agomezgar/rupertobot/cad/archivosCAD.md

# Archivos en FreeCAD

## Descarga aquí los archivos en FreeCAD
| Imagen | Archivo CAD | Comentario |
|:-:|---|---|
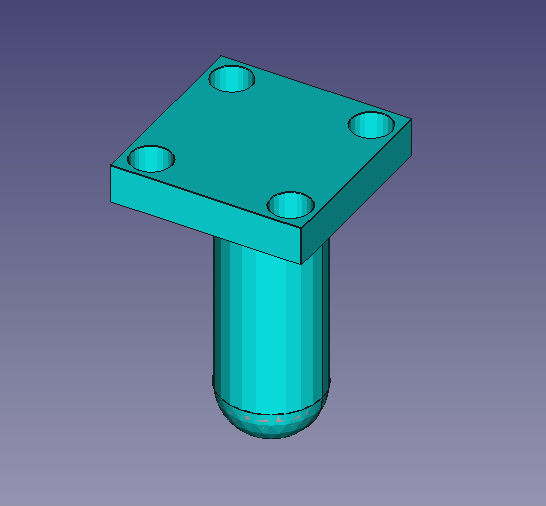
[picture p34: img/3D/ballCaster.png]
Ballcaster
|  | [Ballcaster](../cad/ballcaster.FCStd) | Proporciona un soporte al Rupertobot, intentando reducir el rozamiento con el suelo al mínimo |
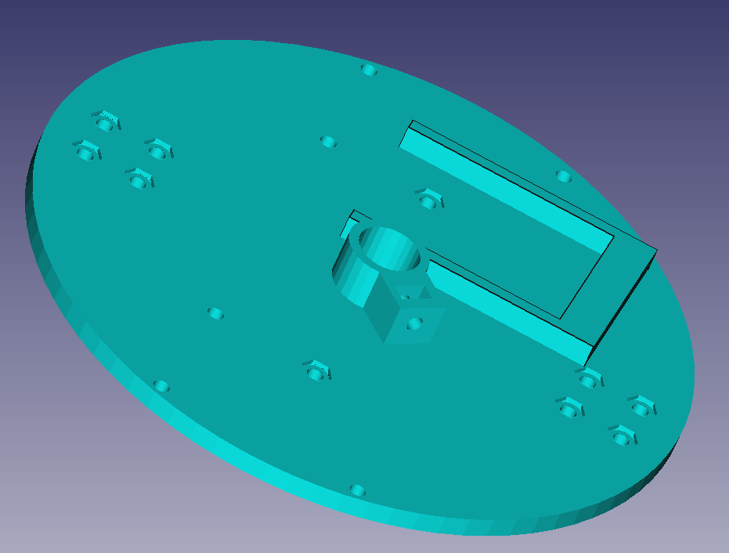
[picture p35: img/3D/plataformaInferior.png]
Plataforma inferior
|  | [Plataforma inferior](../cad/plataformaInferior.FCStd) | Incorpora un sistema de sujeción para bolígrafo o rotulador (experimental, pero la idea es que el Rupertobot acabe dibujando) |
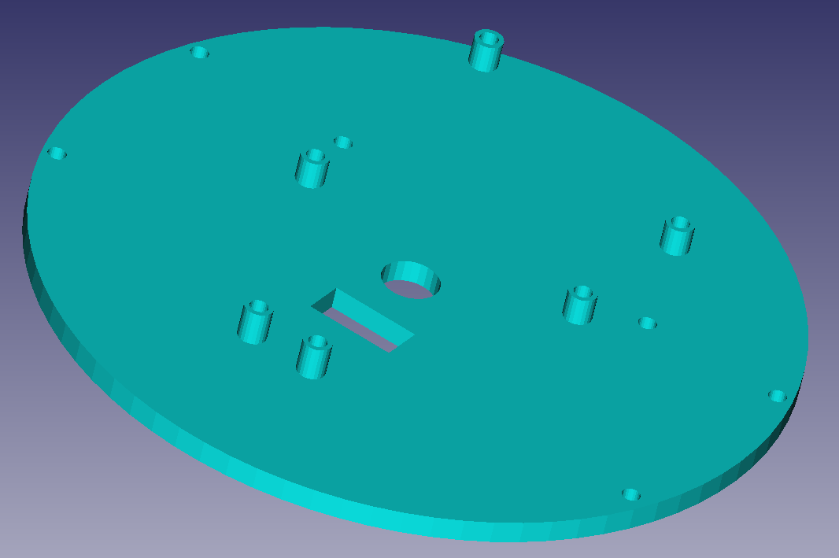
[picture p36: img/3D/plataformaSuperior.png]
Plataforma superior
|  | [Plataforma superior](../cad/plataformaSuperior.FCStd) | Tiene pendiente alguna señal que mejore la orientación a la hora de montarlo sobre la plataforma inferior |
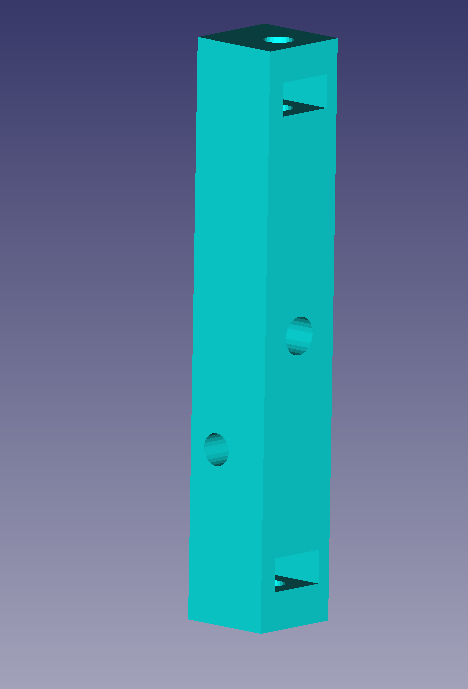
[picture p37: img/3D/columna.png]
Columna
|  | [Columna](../cad/columna.FCStd) | Une las plataformas superior e inferior con un ingenioso (a mí me lo parece) sistema de tornillos y tuercas (Necesitas imprimir seis) |
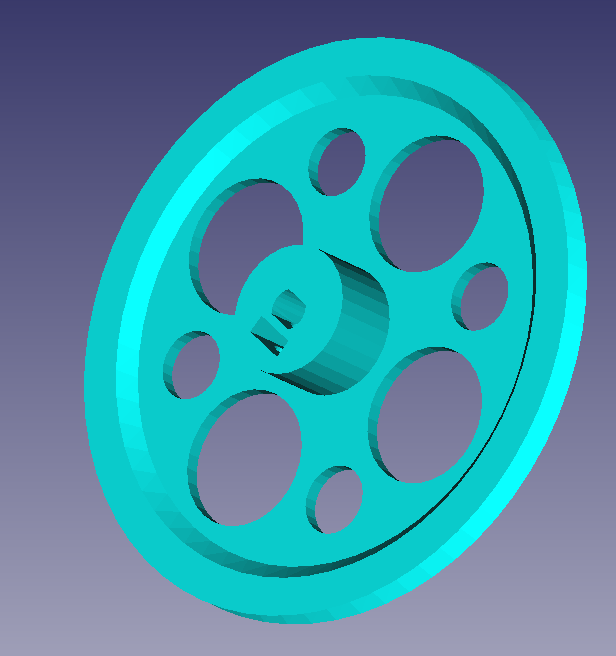
[picture p38: img/3D/ruedaMasaylo.png]
Rueda
|  | [Rueda](../cad/ruedas.FCStd) | La rueda es la del Masaylo (que para eso lo diseñé yo, aunque me ayudaron los compis del Club de Robótica de Granada). En realidad, te sirve cualquier rueda del Escornabot |  
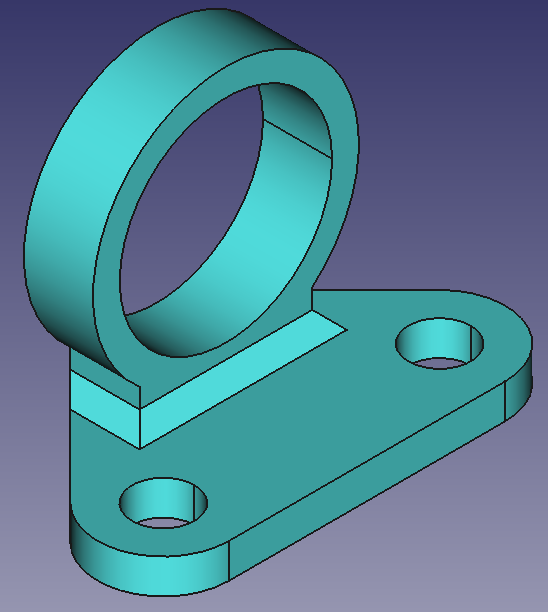
[picture p39: img/3D/soporteZumbador.png]
Soporte del zumbador
|  | Esta pieza, lo confieso, se la he fusilado directamente desde nuestro Masaylo a [Federico Coca](https://github.com/fgcoca). Que la fuerza te acompañe siempre, Fede. |
