agomezgar/rupertobot/STL/archivosSTL.md

# Archivos en STL

## Descarga aquí los archivos en STL
| Imagen | Archivo STL | Comentario |
|:-:|---|---|
| Ballcaster | [Ballcaster](../STL/ballCaster.stl) | Proporciona un soporte al Rupertobot, intentando reducir el rozamiento con el suelo al mínimo (todavía estoy decidiendo si lo reduzco un par de mm para mejorar la tracción, a riesgo de aumentar el cabeceo del robot) |
| Plataforma inferior | [Plataforma inferior](../STL/plataformaInferiorPenholder.stl) | Incorpora un sistema de sujeción para bolígrafo o rotulador |
| Plataforma superior | [Plataforma superior](../STL/plataformaSuperior.stl) | Tiene pendiente alguna señal que mejore la orientación a la hora de montarlo sobre la plataforma inferior |
| Columna | [Columna](../STL/columna.stl) | Une las plataformas superior e inferior con un ingenioso (a mí me lo parece) sistema de tornillos y tuercas (Necesitas imprimir seis) |
| Rueda | [Rueda](../STL/rueda.stl) | La rueda es la del Masaylo (que para eso lo diseñé yo, aunque me ayudaron los compis del Club de Robótica de Granada). En realidad, te sirve cualquier rueda del Escornabot |  
| Soporte de zumbador | [Soporte de zumbador](../STL/soporteZumbador.stl) | Pieza fusilada a [Federico Coca](https://github.com/fgcoca) |
