agomezgar/rupertobot/img/secuenciaPines.odt

MOVIMIENTO HACIA ATRÁS

PASO | MOTOR DERECHO | | | | MOTOR IZQUIERDO
| 2 | 3 | 4 | 5 | 6 | 7 | 8 | 9
1 | 0 | 0 | 0 | 1 | 1 | 0 | 0 | 0
2 | 0 | 0 | 1 | 0 | 0 | 1 | 0 | 0
3 | 0 | 1 | 0 | 0 | 0 | 0 | 1 | 0
4 | 1 | 0 | 0 | 0 | 0 | 0 | 0 | 1
