agomezgar/rupertobot/about.md

# ¿Quién soy? ¡Vaya pregunta!

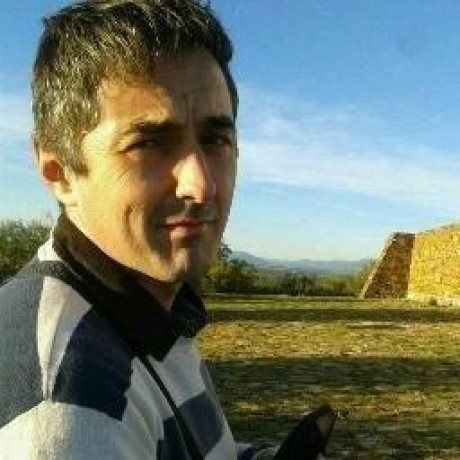
[picture p52: img/perfil.jpg]
Foto de perfil


**Autor**:  Antonio Gómez García

**Bio**: Profe, padre y tecnólogo. Soy penoso en al menos dos de esos perfiles, pero lo intento con toda mi alma todos los días. Soy profe en el [IES Maestro Juan de Ávila](https://maestrojuandeavila.es) de Ciudad Real, como profe de Tecnología, de Robótica y de Ámbito Científico-Tecnológico para los alumnos de Diversificación Curricular. Estos últimos años es lo que más he disfrutado profesionalmente. Como no tengo bastante encima, en la actualidad soy Jefe de Estudios Adjunto, lo que me garantiza un aluvión diario de marrones que voy toreando como mejor puedo, ¡apenas sin llorar!. Soy padre del robot [Masaylo](https://clubroboticagranada.github.io/MASAYLO-CRG), que los amiguetes del [Club de Robótica de Granada](https://clubroboticagranada.github.io/) me ayudaron a digievolucionar hasta su versión 2.0. Soy aficionado a la robótica, la impresión 3D, y el mundo maker en general.

**Presencia en las redes**: Puedes echar un vistazo a mis movidas en mi web del [Aprendiz de Tecnólogo](https://www.aprendizdetecnologo.es); aunque la tengo un poco desactualizada, la estoy recuperando. También actúo bastante en [Twitter](https://twitter.com/antoniotecnocr) (sigo llamando Pryca al Carrefour, me vas a decir a mí que llame a esto X).  

**Publicaciones**  
Aparte de artículos varios en distintos medios (puedes cotejarlos en mi web), soy el orgulloso coautor de dos libros: **Robótica con Arduino** y **Scratch en el cole**, gracias al buen hacer y la disposición de los amigos de <a href="https://serendipiaeditorial.com" target="new">Serendipia Editorial</a>

  | | | 
| :-----------: | :----------: |
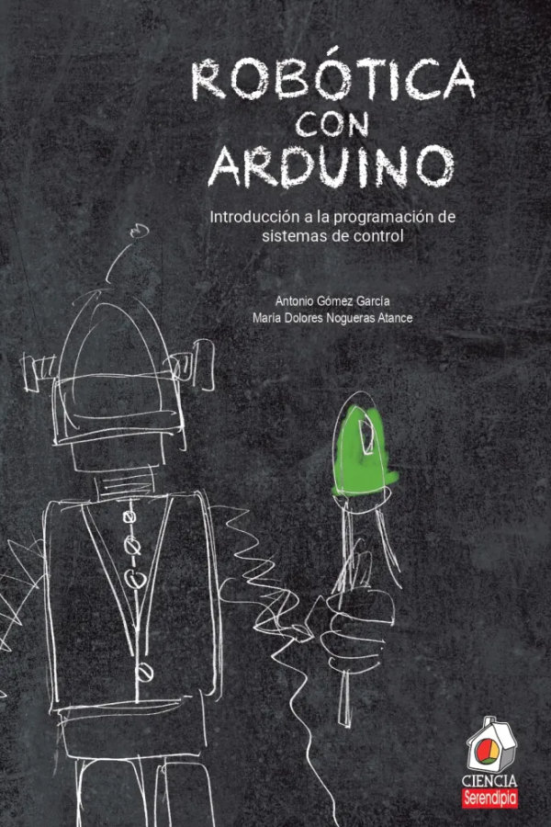
[picture p53: img/roboticaconArduino.jpg]
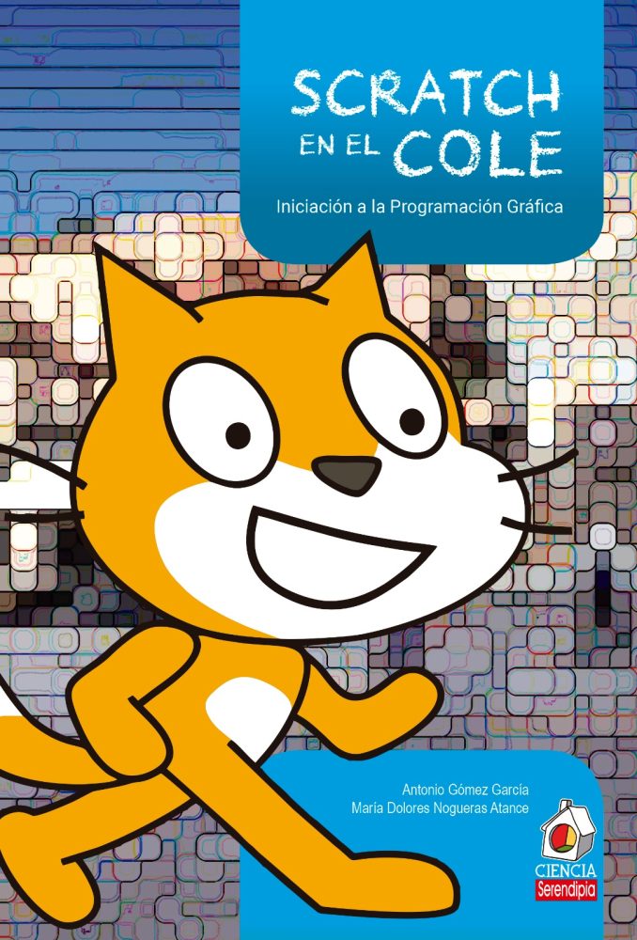
[picture p54: img/scratchenelCole.jpg]
|   | |

**Motivaciones**

Tengo hambre de SABER, porque quiero ENTENDER. Nadie dijo que tengas que hacerme caso. Yo no lo haría.
