agomezgar/rupertobot/archivos/cad.md

# FreeCAD

Aquí tienes los archivos de RupertoBot en FreeCAD

* [Instalación en Windows](windows.md).
* [Instalación en MacOS](macos.md).
* [Instalación en Linux](linux.md).
