agomezgar/rupertobot/archivos/circuito.pdf

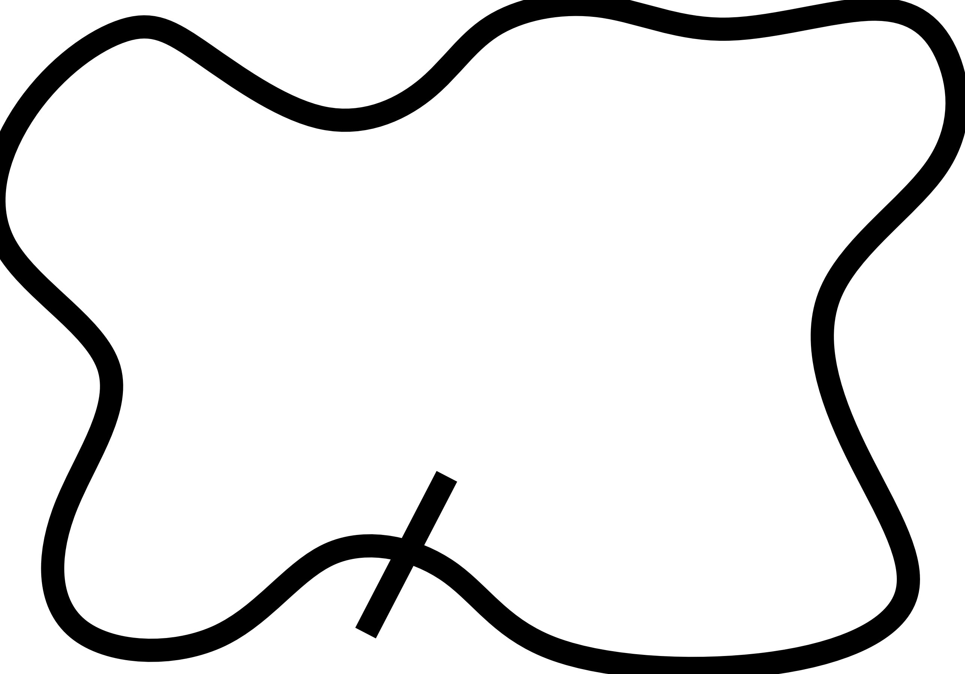
[picture p61: figure]
