agomezgar/rupertobot/img/3D/soporteSensores.png

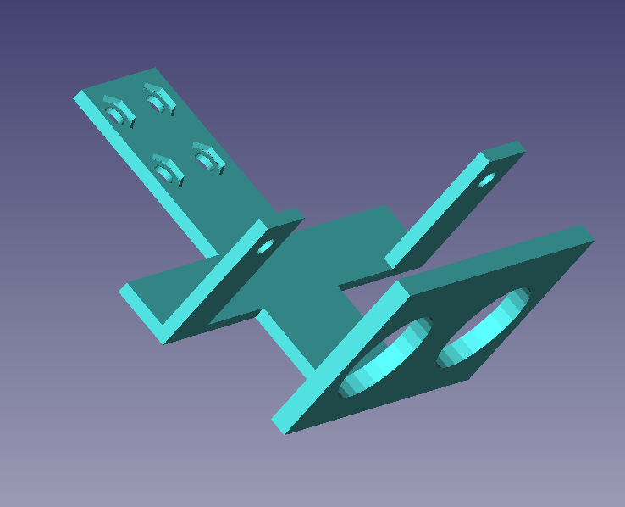
img/3D/soporteSensores.png
