agomezgar/rupertobot/img/3D/soporteSensoresCuernos.png

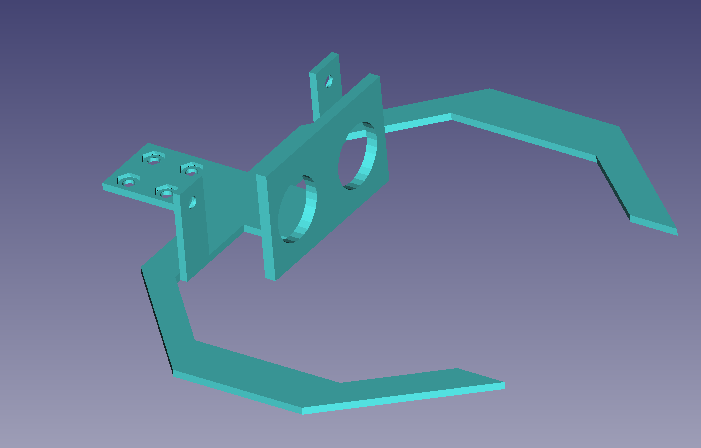
img/3D/soporteSensoresCuernos.png
