agomezgar/rupertobot/img/arduinoIDEInstalarLibreria.png

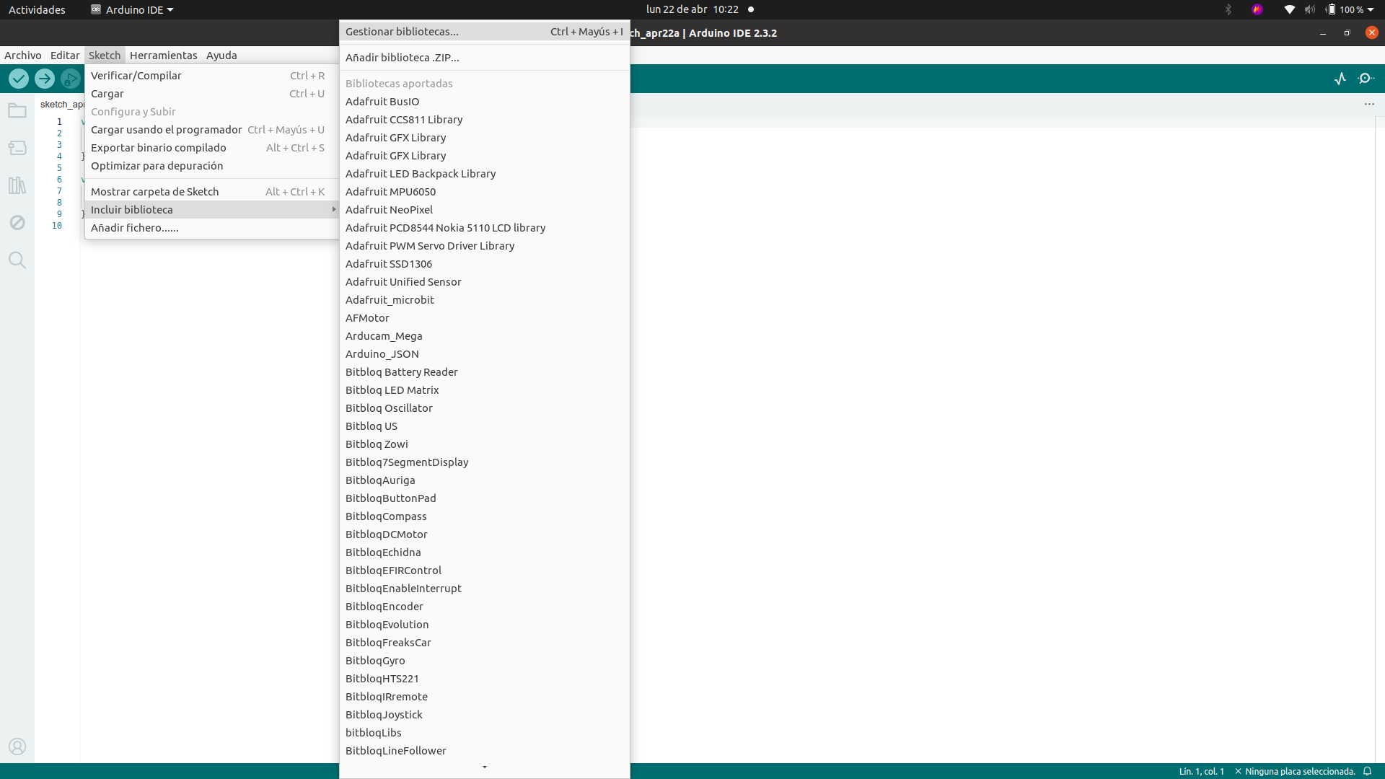
img/arduinoIDEInstalarLibreria.png
