agomezgar/rupertobot/img/arduinoIDEInstalarRupertobot.png

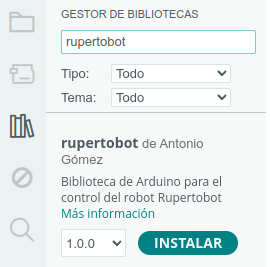
img/arduinoIDEInstalarRupertobot.png
