agomezgar/rupertobot/img/esquemaBase.jpg

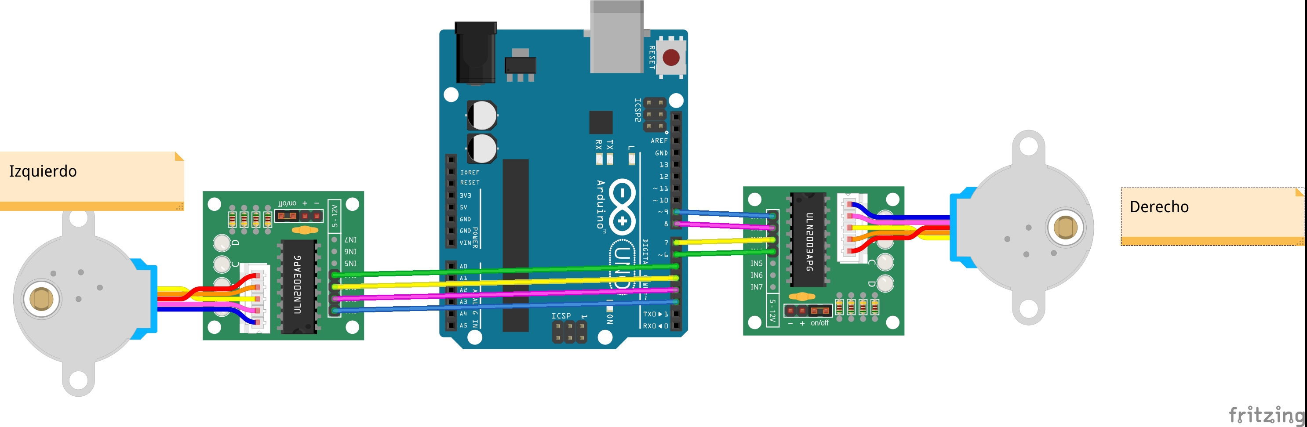
img/esquemaBase.jpg
