agomezgar/rupertobot/img/fotoStepper_files/240x168.png

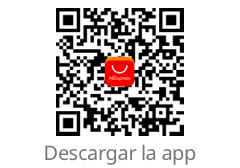
img/fotoStepper_files/240x168.png
