agomezgar/rupertobot/img/fotoStepper_files/Motor-paso-a-paso-de-5V-28BYJ-48-ULN2003-m-dulo-de-prue_003.webp

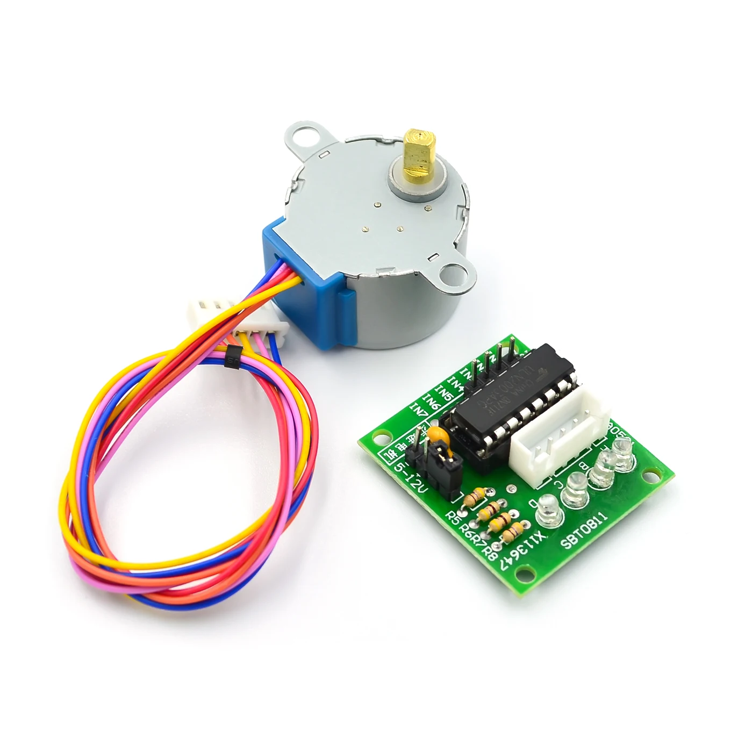
img/fotoStepper_files/Motor-paso-a-paso-de-5V-28BYJ-48-ULN2003-m-dulo-de-prue_003.webp
