agomezgar/rupertobot/img/laberintoBasico.png

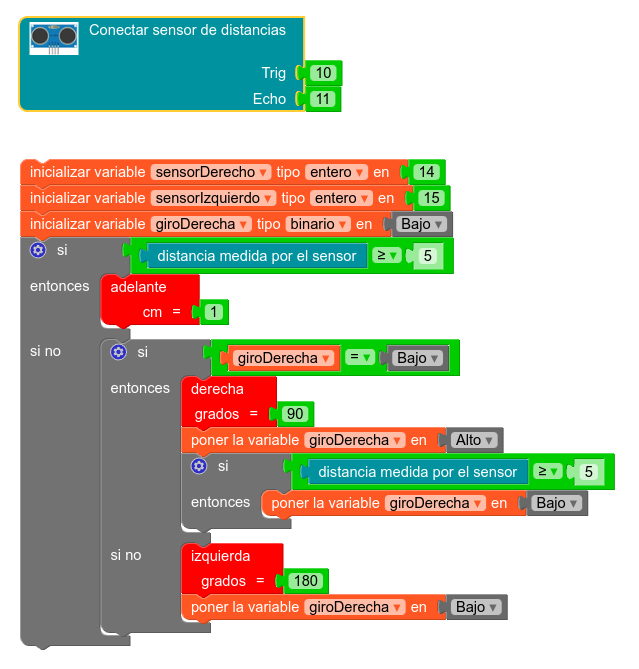
img/laberintoBasico.png
