agomezgar/rupertobot/img/montaColumnas1.png

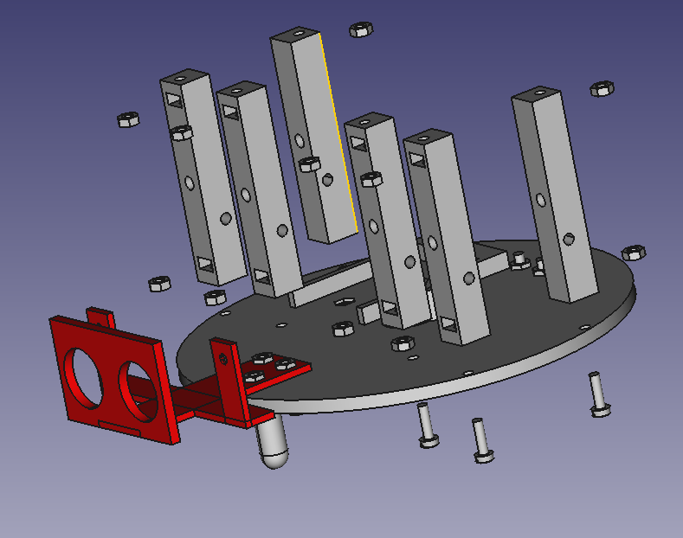
img/montaColumnas1.png
