agomezgar/rupertobot/img/rupertoJedi.png

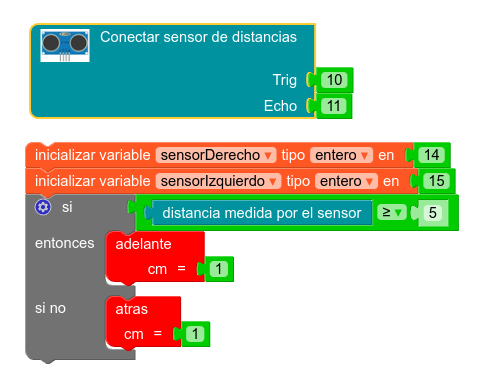
img/rupertoJedi.png
