agomezgar/rupertobot/img/sigueLineasBasico.png

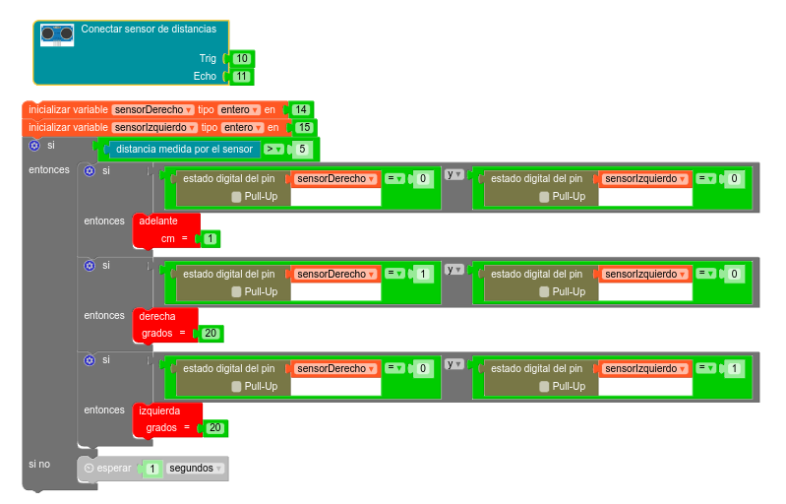
img/sigueLineasBasico.png
