agomezgar/rupertobot/img/stepperDerecho.jpg

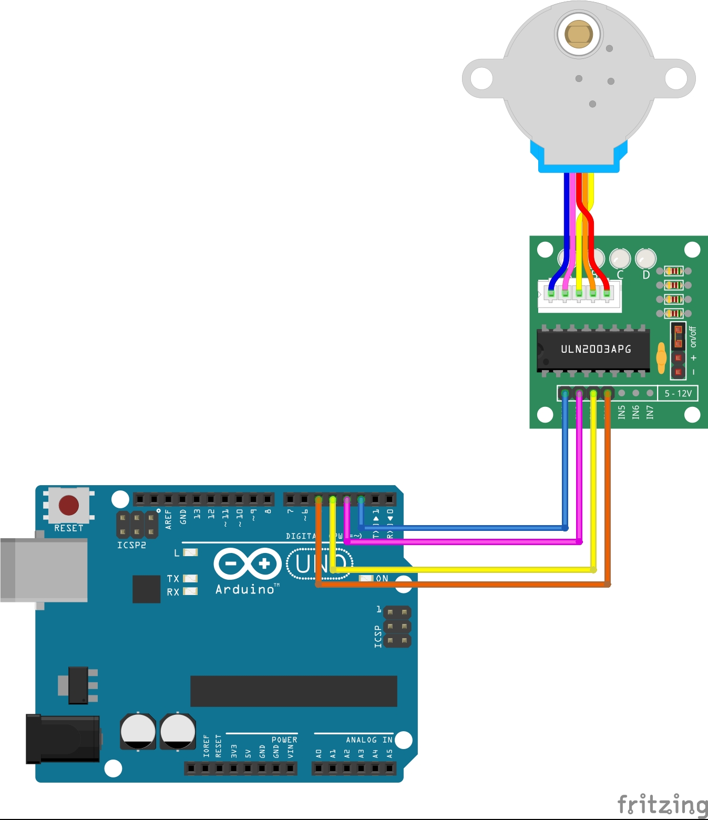
img/stepperDerecho.jpg
