agomezgar/rupertobot/img/stepperDerecho.png

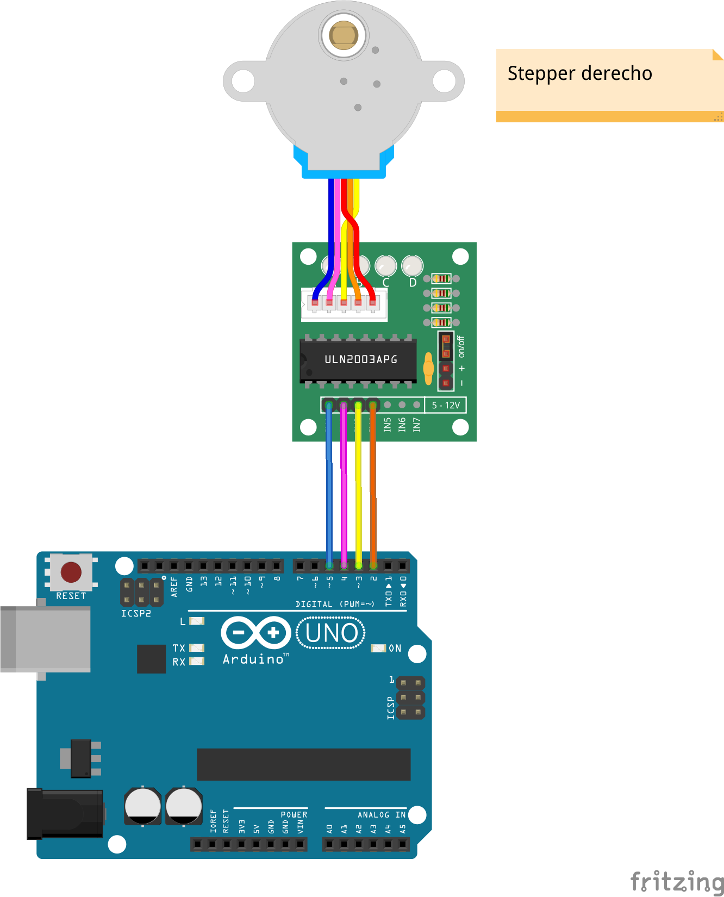
img/stepperDerecho.png
