agomezgar/rupertobot/STL/plataformaInferiorPenholder.stl

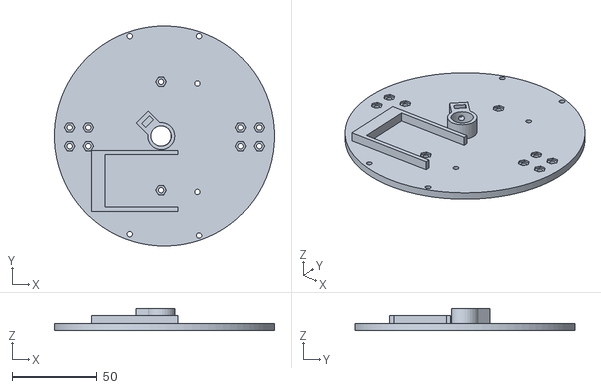
[picture p75: CAD file, 2023-12-23]
STL/plataformaInferiorPenholder.stl
130.0 x 130.0 x 13.0
