agomezgar/rupertobot/cad/plataformaInferior.FCStd

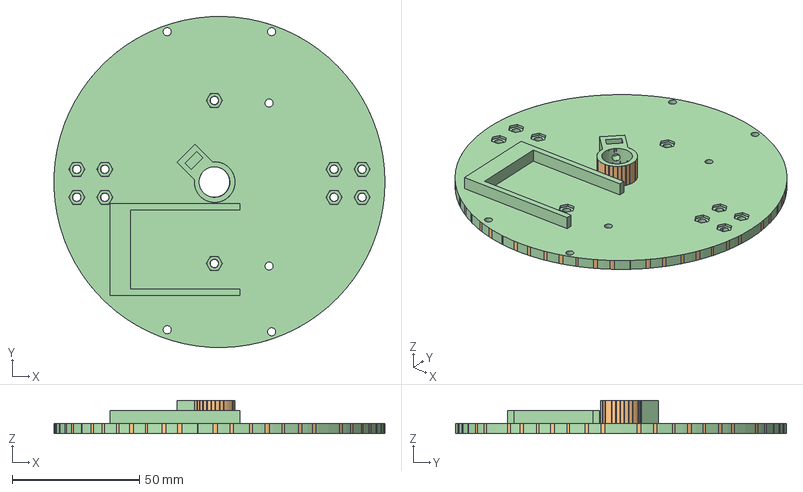
[picture p76: CAD file, 2023-12-23]
cad/plataformaInferior.FCStd
130.0 x 130.0 x 13.0 mm
plataformaInferior
plataformaInferior (Solid)
plataformaInferior (Solid) (Meshed)
