agomezgar/rupertobot/cad/soporteSensoresCuernos.FCStd

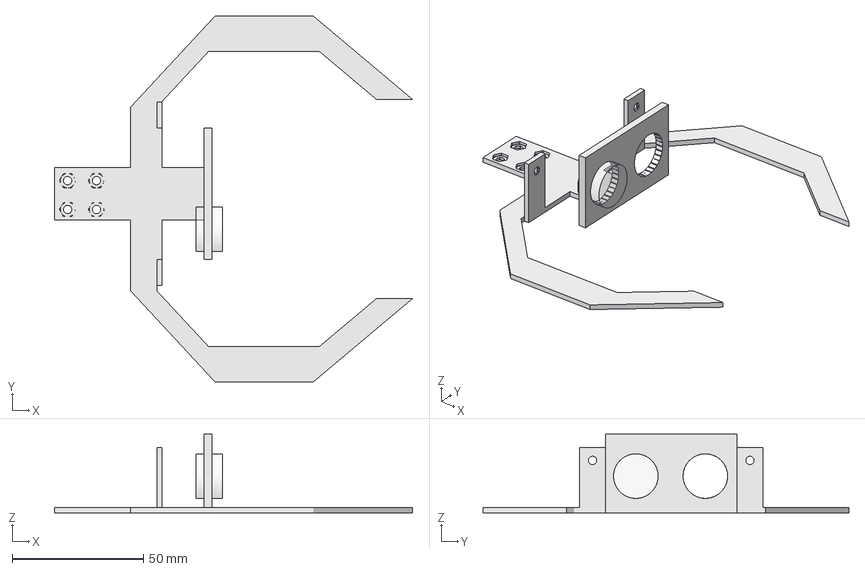
[picture p77: CAD file, 2024-05-05]
cad/soporteSensoresCuernos.FCStd
136.5 x 139.5 x 30.0 mm
Cilindro087
Fusion049 (Meshed)
