agomezgar/rupertobot/STL/ballCasterCorto.stl

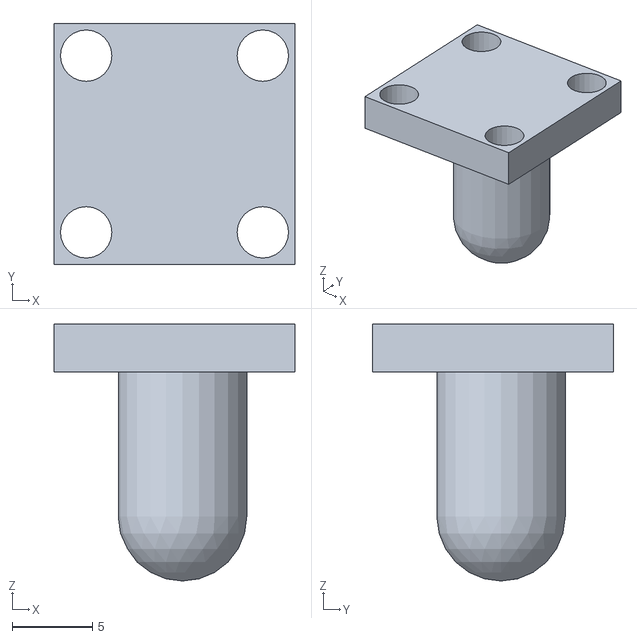
[picture p78: CAD file, 2023-12-23]
STL/ballCasterCorto.stl
15.0 x 15.0 x 16.0
