agomezgar/rupertobot/cad/soporteSensores.FCStd

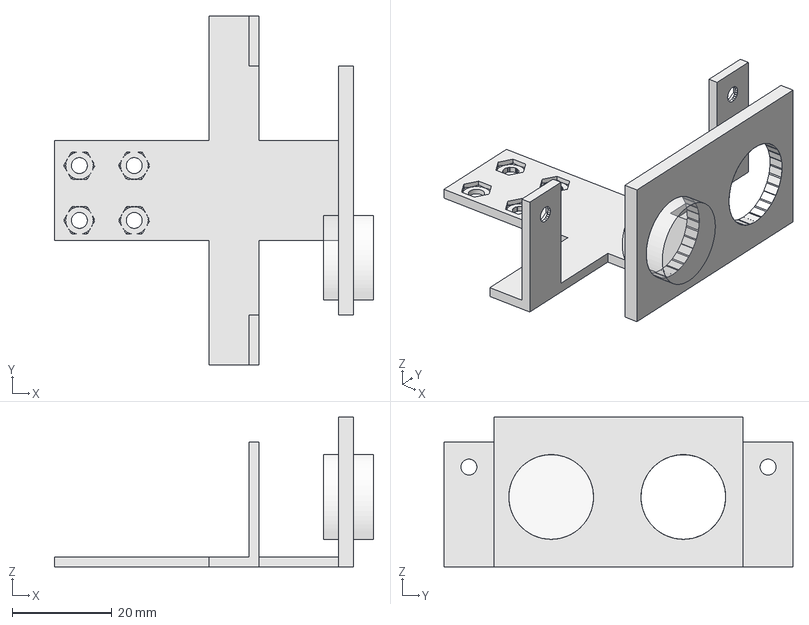
[picture p79: CAD file, 2024-02-04]
cad/soporteSensores.FCStd
64.0 x 70.0 x 30.0 mm
Cilindro087
soporteSensores
soporteSensores (Meshed)
