agomezgar/rupertobot/STL/ballCasterB.stl

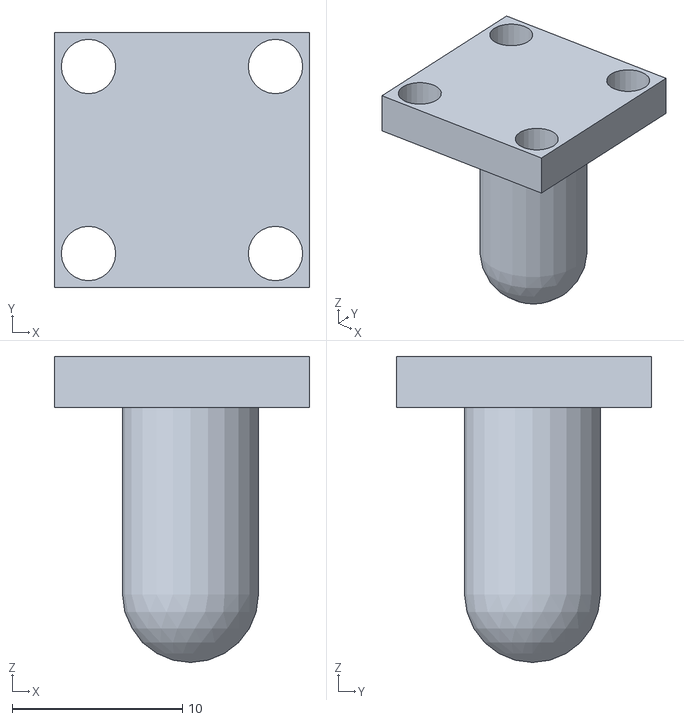
[picture p80: CAD file, 2023-12-23]
STL/ballCasterB.stl
15.0 x 15.0 x 18.0
