agomezgar/rupertobot/cad/soporteZumbador.FCStd

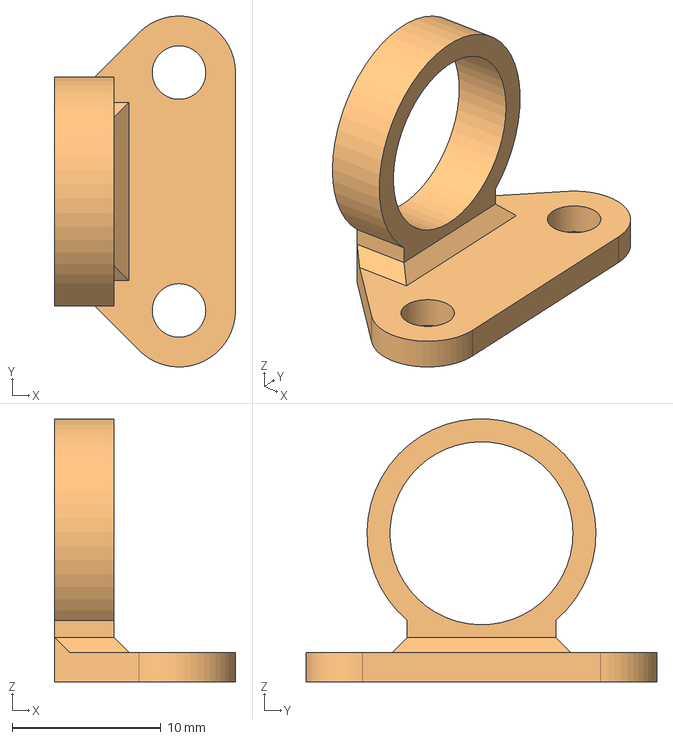
[picture p81: CAD file, 2024-02-04]
cad/soporteZumbador.FCStd
12.2 x 23.6 x 17.7 mm
soporte-zumbador-src (Solid)
