agomezgar/rupertobot/cad/ANIMAMOTORES.FCStd

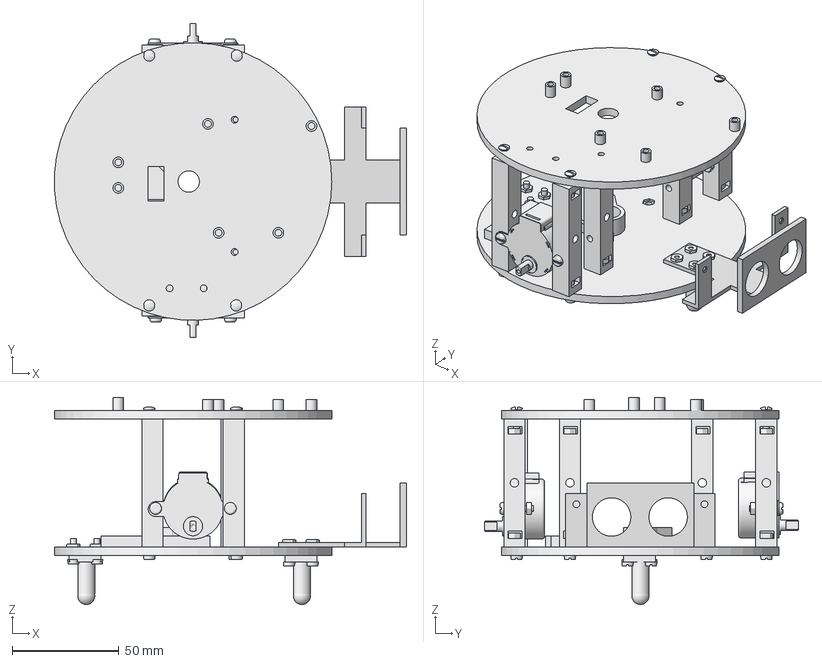
[picture p82: CAD file, 2023-12-31]
cad/ANIMAMOTORES.FCStd
164.9 x 147.0 x 97.0 mm
ballCSensor
plataformaInferior (Solid)
tuercasBallCSensor
tuercasBallCLibre
ballCLibre
soporteSensores (Solid)
tornillosBallClibre
tornillosBallCSensor
M3x14-Tornillo
columnas
tornillosAbajo
tuercasDelante
tuercasAtras
tornillosDerecha
tuercasDerecha
tornillosIzquierda
tuercasIzquierda
plataformaSuperior (Solid)
tornillosSuperiorIzquierda
tornillosSuperiorDerecha
28BYJ-48_v007
28BYJ-48_v6
