agomezgar/rupertobot/STL/ballCasterA (Meshed).stl

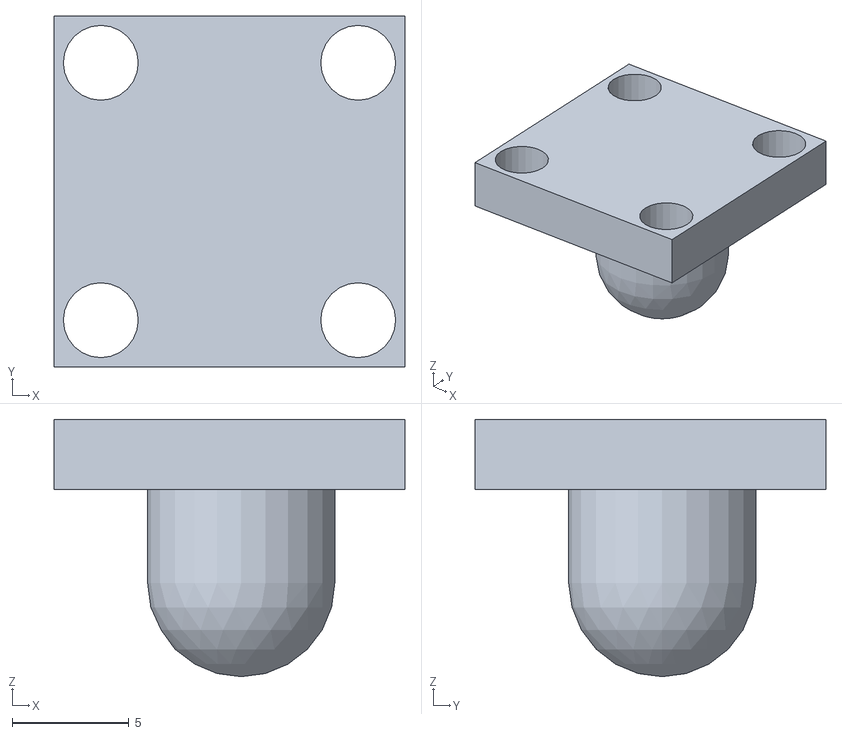
[picture p83: CAD file, 2023-12-23]
STL/ballCasterA (Meshed).stl
15.0 x 15.0 x 11.0
