agomezgar/rupertobot/cad/plataformaSuperior.FCStd

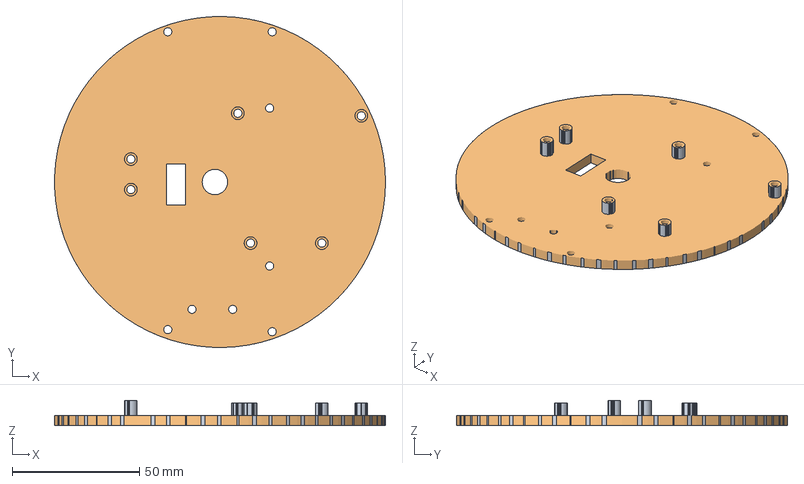
[picture p84: CAD file, 2023-12-31]
cad/plataformaSuperior.FCStd
130.0 x 130.0 x 10.0 mm
plataformaSuperior
plataformaSuperior (Meshed)
