agomezgar/rupertobot/STL/rueda.stl

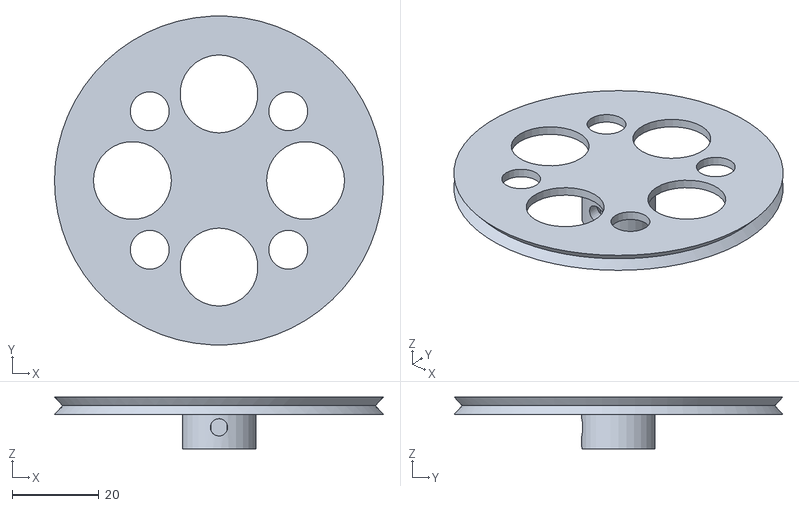
[picture p85: CAD file, 2023-12-23]
STL/rueda.stl
76.0 x 75.9 x 12.0
