agomezgar/rupertobot/cad/ANIMACOLUMNAS.FCStd

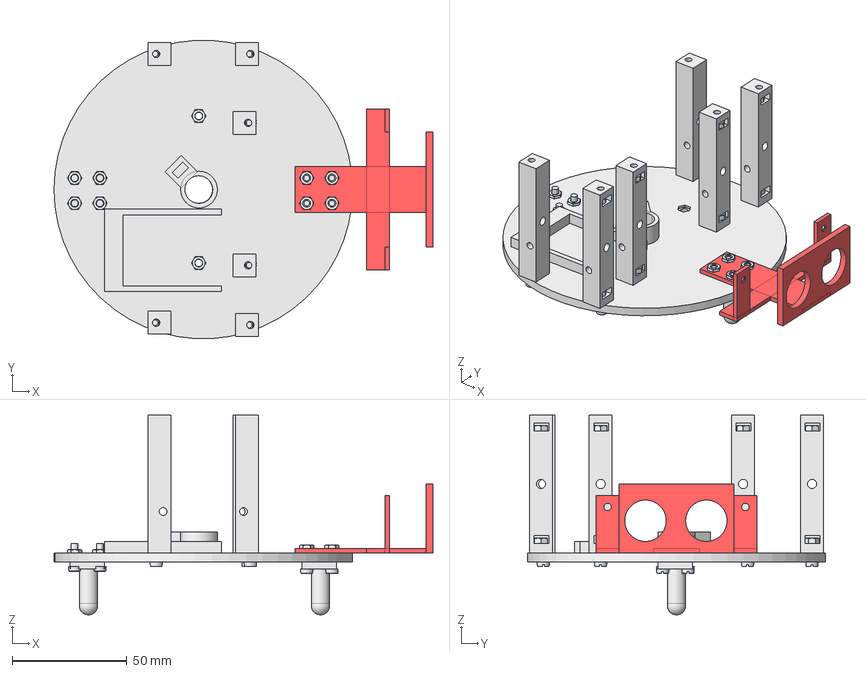
[picture p86: CAD file, 2023-12-31]
cad/ANIMACOLUMNAS.FCStd
165.0 x 129.8 x 87.0 mm
ballCSensor
plataformaInferior (Solid)
tuercasBallCSensor
tuercasBallCLibre
ballCLibre
soporteSensores (Solid)
tornillosBallClibre
tornillosBallCSensor
columnas
tornillosAbajo
tuercasDelante
tuercasAtras
