agomezgar/rupertobot/cad/ANIMABALLCASTER.FCStd

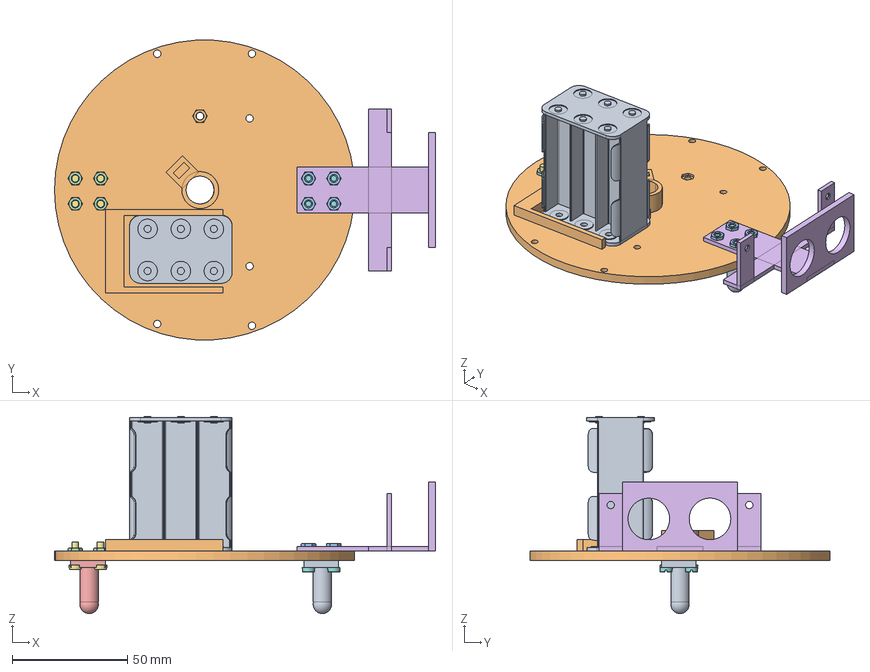
[picture p87: CAD file, 2023-12-31]
cad/ANIMABALLCASTER.FCStd
165.0 x 129.8 x 85.4 mm
ballCSensor
plataformaInferior (Solid)
tuercasBallCSensor
tuercasBallCLibre
ballCLibre
soporteSensores (Solid)
tornillosBallClibre
tornillosBallCSensor
6 x AAA Holder
