agomezgar/rupertobot/cad/columna.FCStd

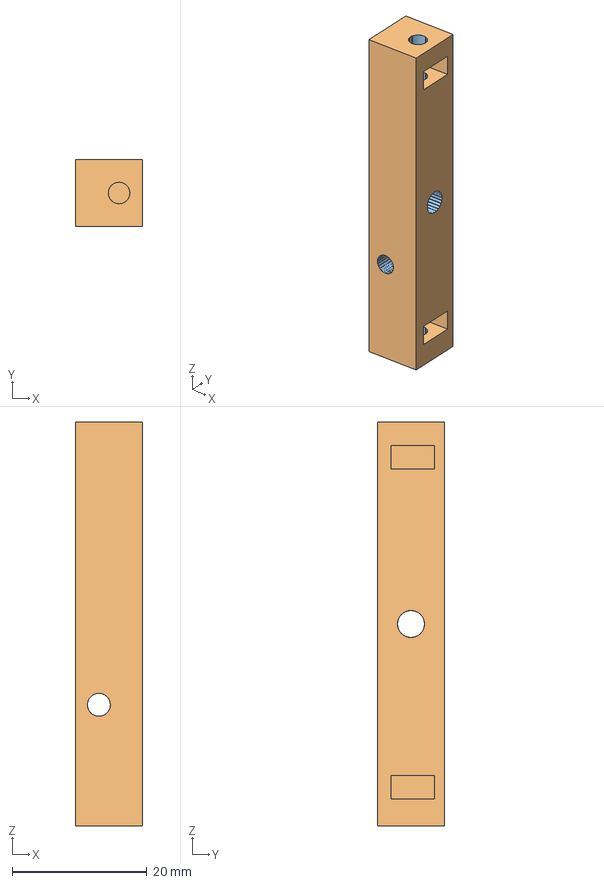
[picture p88: CAD file, 2023-12-23]
cad/columna.FCStd
10.0 x 10.0 x 60.0 mm
columna
columna (Solid)
columna (Meshed)
