agomezgar/rupertobot/cad/ballcaster.FCStd

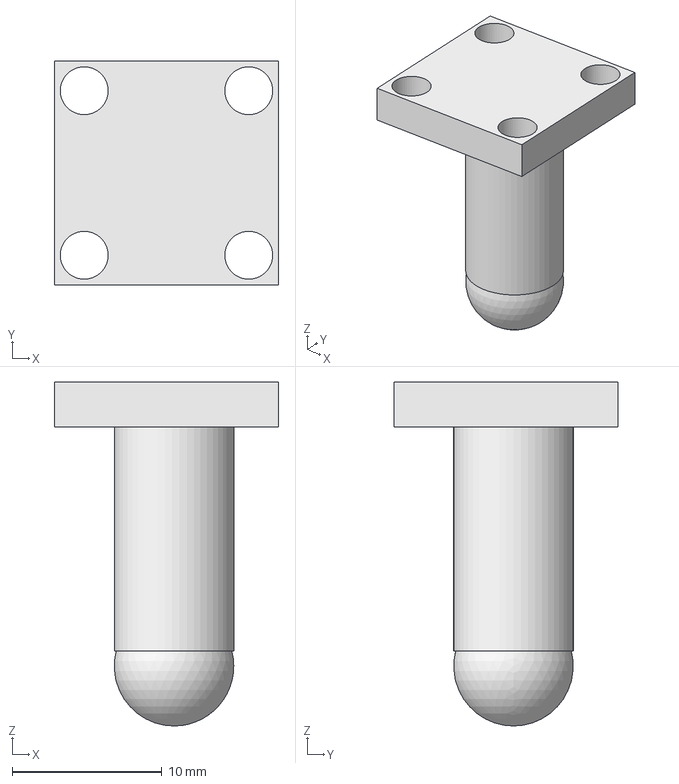
[picture p89: CAD file, 2023-12-23]
cad/ballcaster.FCStd
15.0 x 15.0 x 23.0 mm
