agomezgar/rupertobot/(list of files, cad)

Other CAD files:
cad/ruedas.FCStd
STL/ballCaster.stl
STL/columna.stl
STL/plataformaSuperior.stl
STL/soporteSensores.stl
STL/soporteSensoresCuernos.stl
STL/soporteZumbador.stl
