agomezgar/rupertobot/(list of files, drawings)

Other design files:
circuitos/alimentacionArduino.fzz
circuitos/alimentacionDrivers2.fzz
circuitos/alimentacionDrivers.fzz
circuitos/conexionUS.fzz
circuitos/sensoresIR.fzz
circuitos/stepperDerecho.fzz
circuitos/steppers.fzz
circuitos/zumbador.fzz
img/esquemas/esquemaBase.fzz
