agomezgar/rupertobot/(commit log)

2023-12-23 Prueba de subida
    [ballCaster.stl, ballCasterA (Meshed).stl, ballCasterB.stl, ballCasterCorto.stl, ballcaster.FCStd, columna.FCStd, columna.stl, esquemaBase.fzz]
2023-12-23 Cambio de tema
2023-12-31 Primeras animaciones
    [ANIMABALLCASTER.FCStd, animaciones.FCStd, plataformaSuperior.FCStd, plataformaSuperior.stl, soporte-zumbador-src(1).FCStd]
2023-12-31 Hi once more
    [ballCaster.stl, ballCasterA (Meshed).stl, ballCasterB.stl, ballCasterCorto.stl, ballcaster.FCStd, columna.FCStd, columna.stl, esquemaBase.fzz]
2023-12-31 Learning a lot
    [ballCaster.stl, ballCasterA (Meshed).stl, ballCasterB.stl, ballCasterCorto.stl, ballcaster.FCStd, columna.FCStd, columna.stl, esquemaBase.fzz]
2023-12-31 Avanzando en las instrucciones de instalación
    [ANIMACOLUMNAS.FCStd, plataformaSuperior.FCStd]
2023-12-31 Instrucciones de montaje semicompletas
    [ANIMAMOTORES.FCStd]
2023-12-31 Resolviendo error de imagen con HCSR04
    [ballCaster.stl, ballCasterA (Meshed).stl, ballCasterB.stl, ballCasterCorto.stl, ballcaster.FCStd, columna.FCStd, columna.stl, esquemaBase.fzz]
2024-01-01 Instrucciones de conexionado
    [alimentacionArduino.fzz, alimentacionDrivers.fzz, alimentacionDrivers2.fzz, ballCaster.stl, ballCasterA (Meshed).stl, ballCasterB.stl, ballCasterCorto.stl, ballcaster.FCStd]
2024-01-01 Finalizada primera versión (incompleta)
    [conexionUS.fzz, sensoresIR.fzz, soporteZumbador.stl, steppers.fzz, zumbador.fzz]
2024-01-04 Primeros ejemplos de movimiento
    [stepperDerecho.fzz, steppers.fzz]
2024-01-04 Ejemplos de programación de giro
2024-01-14 Añadidos ejemplos de funciones sin parámetros
    [ballCaster.stl, ballCasterA (Meshed).stl, ballCasterB.stl, ballCasterCorto.stl, ballcaster.FCStd, columna.FCStd, columna.stl, esquemaBase.fzz]
2024-01-14 Añadidas funciones sin parámetros (el anterior commit estaba mal)
    [ballCaster.stl, ballCasterA (Meshed).stl, ballCasterB.stl, ballCasterCorto.stl, ballcaster.FCStd, columna.FCStd, columna.stl, esquemaBase.fzz]
2024-02-04 Nuevas imágenes para Feria Niña
    [animaciones.FCStd, ballCaster.stl, plataformaSuperior.stl, soporte-zumbador-src(1).FCStd, soporteSensores.FCStd, soporteSensores.stl, soporteZumbador.FCStd]
2024-04-21 Nuevo artículo sobre siguelíneas
    [ballCaster.stl, ballCasterA (Meshed).stl, ballCasterB.stl, ballCasterCorto.stl, ballcaster.FCStd, columna.FCStd, columna.stl, esquemaBase.fzz]
2024-04-25 Desafíos robóticos y librería Rupertobot
    [ballCaster.stl, ballCasterA (Meshed).stl, ballCasterB.stl, ballCasterCorto.stl, ballcaster.FCStd, columna.FCStd, columna.stl, esquemaBase.fzz]
2024-05-05 Nuevas piezas y actualizaciones varias
    [soporteSensoresCuernos.FCStd, soporteSensoresCuernos.stl]
